Lizhou31/TfminiPlus_Tower/README.md

# TfminiPlus_Tower

## An easy use distance sensors (Tfmini-plus) Tower
* Plug and Play
* Easy to Install

## TODO
* Add watchdog to prevent I2C connection error
* Add future extendible
