Lizhou31/TfminiPlus_Tower/TPT_PCB/TPT_PCB.kicad_pcb

## KiCad design TPT_PCB/TPT_PCB.kicad_pcb (2021-08-17)

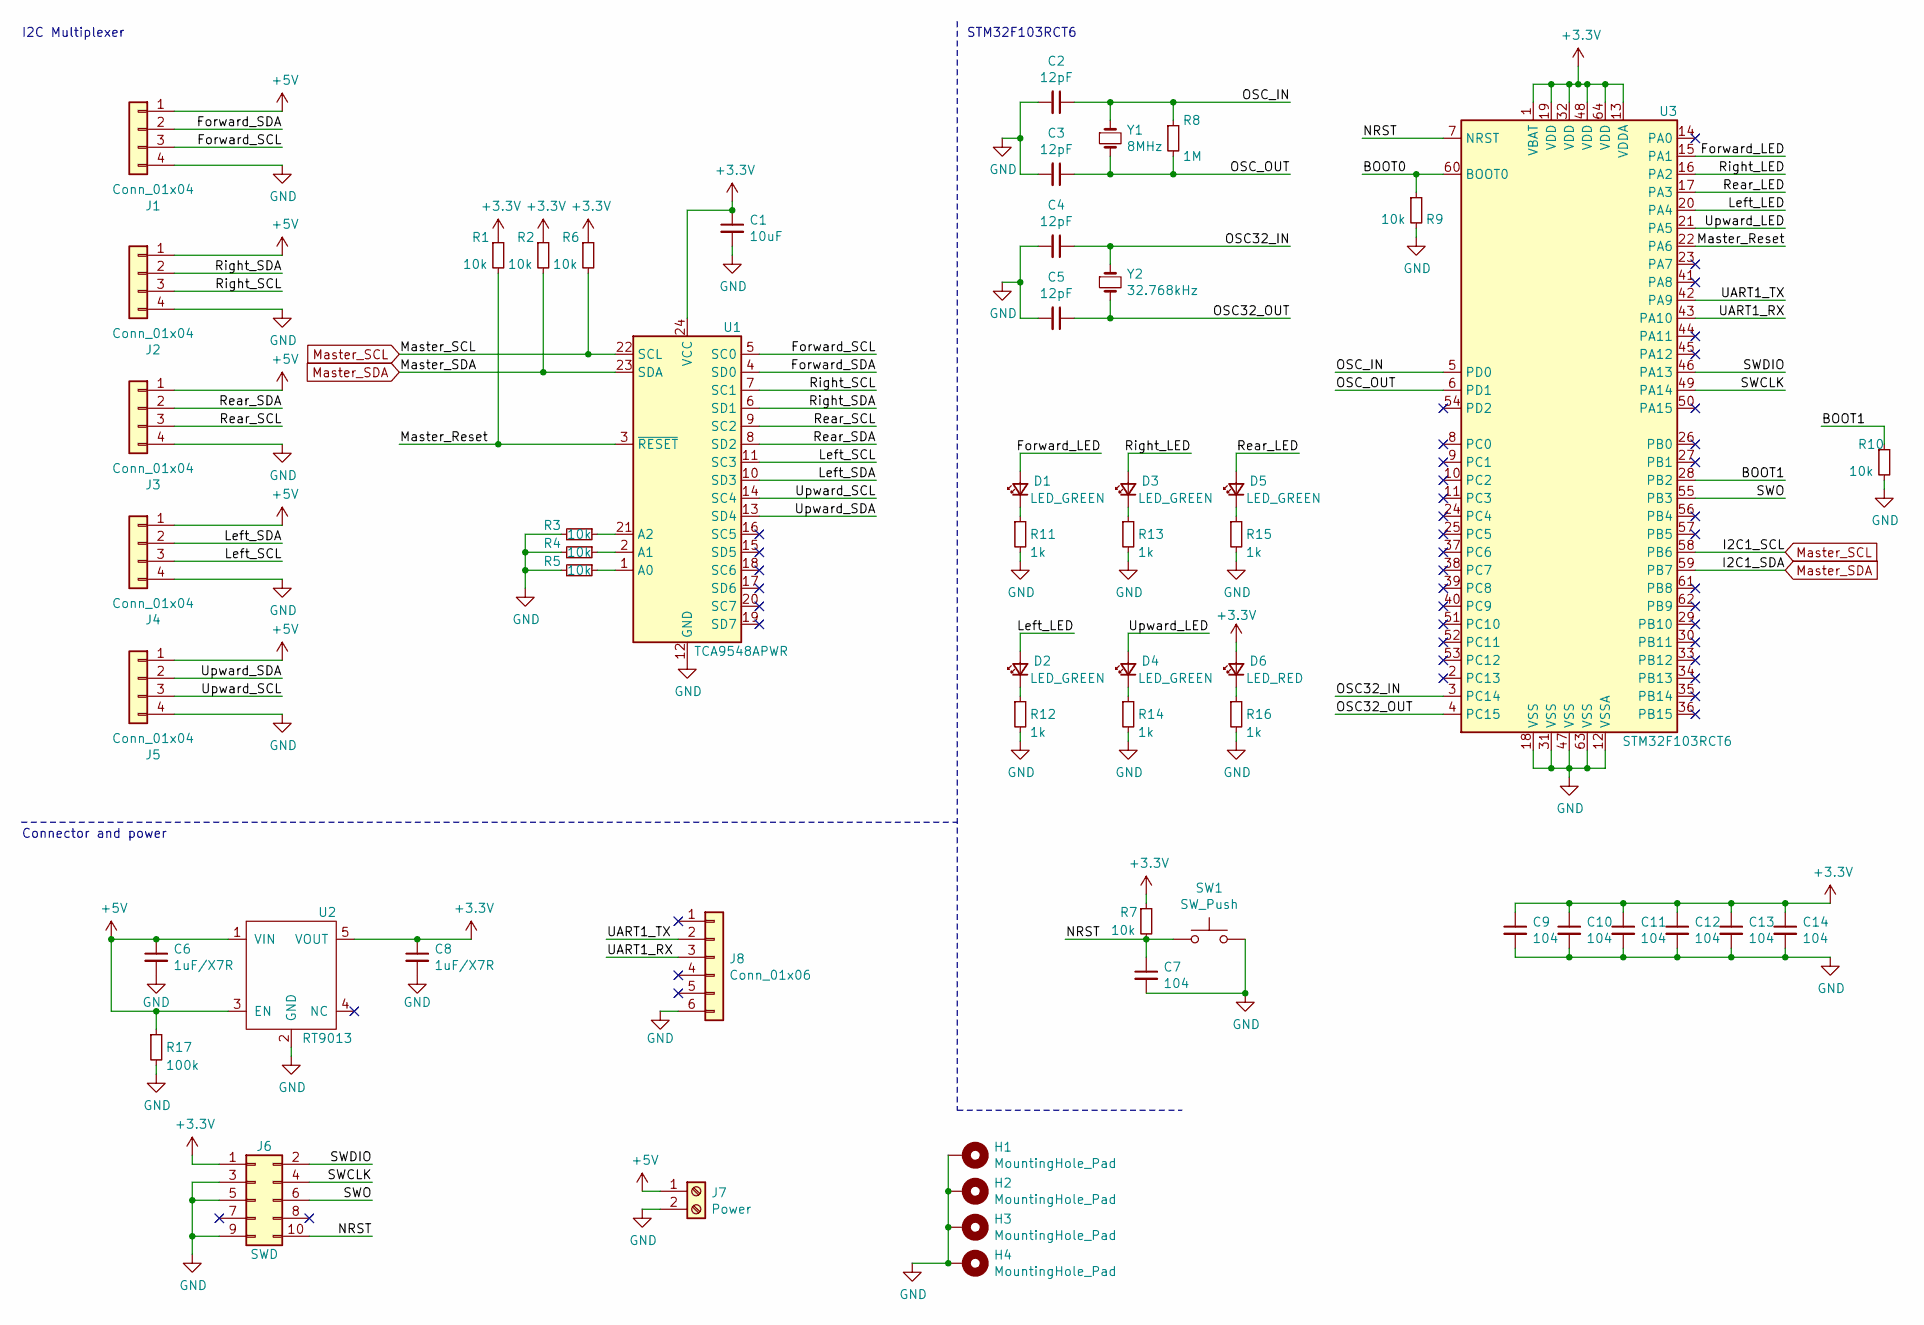
[picture p1: schematic TPT_PCB.sch, tfmini_tower]

Parts:
C1: 10uF; C_0805_2012Metric
C2, C3, C4, C5: 12pF; C_0805_2012Metric
C6, C8: 1uF/X7R; C_0805_2012Metric
C7, C9, C10, C11, C12, C13, C14: 104; C_0805_2012Metric
D1, D2, D3, D4, D5: LED_GREEN; LED_0805_2012Metric
D6: LED_RED; LED_0805_2012Metric
H1, H2, H3, H4: MountingHole_Pad; MountingHole_4.3mm_M4_Pad_Via
J1, J2, J3, J4: Conn_01x04; JST_GH_SM04B-GHS-TB_1x04-1MP_P1.25mm_Horizontal
J5: Conn_01x04; JST_GH_BM04B-GHS-TBT_1x04-1MP_P1.25mm_Vertical
J6: SWD; Samtec_HLE-105-02-xx-DV-TE_2x05_P2.54mm_Horizontal
J7: Power; TerminalBlock_Phoenix_PT-1,5-2-3.5-H_1x02_P3.50mm_Horizontal
J8: Conn_01x06; JST_GH_SM06B-GHS-TB_1x06-1MP_P1.25mm_Horizontal
R1, R2, R3, R4, R5, R6, R7, R9, R10: 10k; R_0805_2012Metric
R8: 1M; R_0805_2012Metric
R11, R12, R13, R14, R15, R16: 1k; R_0805_2012Metric
R17: 100k; R_0805_2012Metric
SW1: SW_Push; SW_Push_1P1T_NO_6x6mm_H9.5mm
U1: TCA9548APWR; TSSOP-24_4.4x7.8mm_P0.65mm
U2: RT9013; SOT94P279X129-5N
U3: STM32F103RCT6; LQFP-64_10x10mm_P0.5mm
Y1: 8MHz; XTAL_ABLS-8.000MHZ-B2-T
Y2: 32.768kHz; XTAL_AB26TRB-32.768KHZ-T

Connections:
+3V3: C1.1, C8.1, C9.1, C10.1, C11.1, C12.1, C13.1, C14.1, D6.2 (A), J6.1, R1.1, R2.1, R6.1, R7.1, U1.24 (VCC), U2.5 (VOUT), U3.1 (VBAT), U3.13 (VDDA), U3.19 (VDD), U3.32 (VDD), U3.48 (VDD), U3.64 (VDD)
+5V: C6.1, J1.1, J2.1, J3.1, J4.1, J5.1, J7.1, R17.1, U2.1 (VIN), U2.3 (EN)
/BOOT0: R9.1, U3.60 (BOOT0)
/BOOT1: R10.1, U3.28 (PB2)
/Forward_LED: D1.2 (A), U3.15 (PA1)
/Forward_SCL: J1.3, U1.5 (SC0)
/Forward_SDA: J1.2, U1.4 (SD0)
/Left_LED: D2.2 (A), U3.20 (PA4)
/Left_SCL: J4.3, U1.11 (SC3)
/Left_SDA: J4.2, U1.10 (SD3)
/Master_Reset: R1.2, U1.3 (~RESET), U3.22 (PA6)
/NRST: C7.1, J6.10, R7.2, SW1.1, U3.7 (NRST)
/OSC32_IN: C4.1, U3.3 (PC14), Y2.1
/OSC32_OUT: C5.1, U3.4 (PC15), Y2.2
/OSC_IN: C2.1, R8.1, U3.5 (PD0), Y1.1
/OSC_OUT: C3.1, R8.2, U3.6 (PD1), Y1.2
/Rear_LED: D5.2 (A), U3.17 (PA3)
/Rear_SCL: J3.3, U1.9 (SC2)
/Rear_SDA: J3.2, U1.8 (SD2)
/Right_LED: D3.2 (A), U3.16 (PA2)
/Right_SCL: J2.3, U1.7 (SC1)
/Right_SDA: J2.2, U1.6 (SD1)
/SWCLK: J6.4, U3.49 (PA14)
/SWDIO: J6.2, U3.46 (PA13)
/SWO: J6.6, U3.55 (PB3)
/UART1_RX: J8.3, U3.43 (PA10)
/UART1_TX: J8.2, U3.42 (PA9)
/Upward_LED: D4.2 (A), U3.21 (PA5)
/Upward_SCL: J5.3, U1.14 (SC4)
/Upward_SDA: J5.2, U1.13 (SD4)
GND: C1.2, C2.2, C3.2, C4.2, C5.2, C6.2, C7.2, C8.2, C9.2, C10.2, C11.2, C12.2, C13.2, C14.2, H1.1, H2.1, H3.1, H4.1, J1.4, J2.4, J3.4, J4.4, J5.4, J6.3, J6.5, J6.9, J7.2, J8.6, R3.2, R4.2, R5.2, R9.2, R10.2, R11.2, R12.2, R13.2, R14.2, R15.2, R16.2, R17.2, SW1.2, U1.12 (GND), U2.2 (GND), U3.12 (VSSA), U3.18 (VSS), U3.31 (VSS), U3.47 (VSS), U3.63 (VSS)
Master_SCL: R6.2, U1.22 (SCL), U3.58 (PB6)
Master_SDA: R2.2, U1.23 (SDA), U3.59 (PB7)
unnamed: D1.1 (K), R11.1
unnamed: D2.1 (K), R12.1
unnamed: D3.1 (K), R13.1
unnamed: D4.1 (K), R14.1
unnamed: D5.1 (K), R15.1
unnamed: D6.1 (K), R16.1
unnamed: R3.1, U1.21 (A2)
unnamed: R4.1, U1.2 (A1)
unnamed: R5.1, U1.1 (A0)

Notes on the sheet:
I2C Multiplexer
Connector and power
STM32F103RCT6

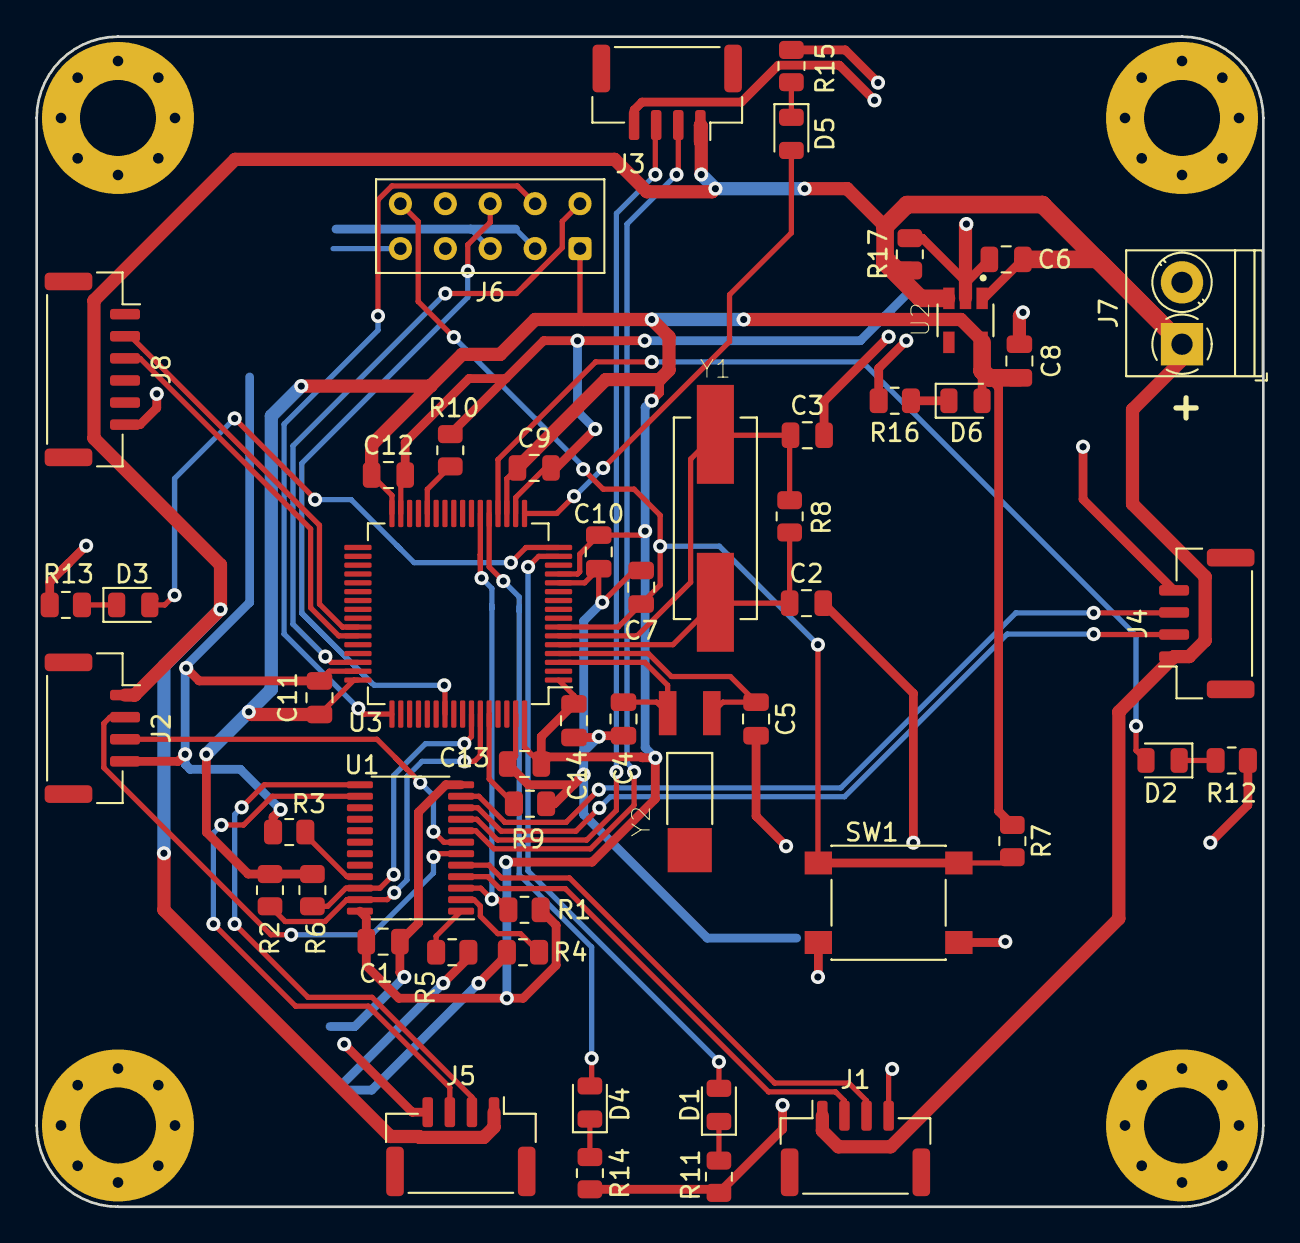
[picture p2: board TPT_PCB.kicad_pcb from above]

Board: 2 copper layers, 69.4 x 66.2 mm, 55 parts (0 on the bottom side), 42 nets.
