Lizhou31/TfminiPlus_Tower/DevSpace/Core/Src/main.c

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
/* Includes ------------------------------------------------------------------*/
#include "main.h"

/* USER CODE BEGIN Includes */
#include "tfmini_plus.h"
/* USER CODE END Includes */

/* USER CODE BEGIN PD */
// #define DEBUG
/* USER CODE END PD */

/* USER CODE BEGIN PM */
I2CHandler i2chandler;
/* USER CODE END PM */


void SystemClock_Config(void);
static void MX_GPIO_Init(void);
static void MX_I2C1_Init(void);
static void MX_USART1_UART_Init(void);
static void MX_IWDG_Init(void);
/* USER CODE BEGIN PFP */
#ifdef DEBUG
extern void initialise_monitor_handles(void);
#endif
/* USER CODE END PFP */

/**
  * @brief  The application entry point.
  * @retval int
  */
int main(void)
{
  /* USER CODE BEGIN 1 */
#ifdef DEBUG
  initialise_monitor_handles();
#endif
  /* USER CODE END 1 */

  /* MCU Configuration--------------------------------------------------------*/

  /* Reset of all peripherals, Initializes the Flash interface and the Systick. */

  LL_APB2_GRP1_EnableClock(LL_APB2_GRP1_PERIPH_AFIO);
  LL_APB1_GRP1_EnableClock(LL_APB1_GRP1_PERIPH_PWR);

  NVIC_SetPriorityGrouping(NVIC_PRIORITYGROUP_4);

  /* System interrupt init*/

  /** DISABLE: JTAG-DP Disabled and SW-DP Disabled
  */
  LL_GPIO_AF_EnableRemap_SWJ();

  /* USER CODE BEGIN Init */
  UARTHANDLER uart1handler;
  /* USER CODE END Init */

  /* Configure the system clock */
  SystemClock_Config();

  /* USER CODE BEGIN SysInit */
  LL_SYSTICK_EnableIT();
  NVIC_SetPriority(SysTick_IRQn, (1UL << __NVIC_PRIO_BITS) - 1UL); /* set Priority for Systick Interrupt */
                                                                   /* USER CODE END SysInit */

  /* Initialize all configured peripherals */
  MX_GPIO_Init();
  MX_I2C1_Init();
  MX_USART1_UART_Init();
  // MX_IWDG_Init();
  /* USER CODE BEGIN 2 */
  i2chandler_init(&i2chandler, I2C1);
  uart1handler->Instance = USART1;
  uart1handler->ErrorCode = HAL_UART_ERROR_NONE;
  __IO uint16_t mavlinklength = 0;
  tfmini_handler tfmini[] =
      {{.DevAddress = 0x10,
        .channel = 0b00000001,
        .ErrorCode = TFMINI_ERROR_NONE},
       {.DevAddress = 0x13,
        .channel = 0b00000010,
        .ErrorCode = TFMINI_ERROR_NONE},
       {.DevAddress = 0x12,
        .channel = 0b00000100,
        .ErrorCode = TFMINI_ERROR_NONE},
       {.DevAddress = 0x11,
        .channel = 0b00001000,
        .ErrorCode = TFMINI_ERROR_NONE},
       {.DevAddress = 0x14,
        .channel = 0b00010000,
        .ErrorCode = TFMINI_ERROR_NONE}};
  mavlink_message_t msg;
  uint8_t Txmsg[174] = {0};

  LL_GPIO_SetOutputPin(GPIOA, LL_GPIO_PIN_6);
  Delay(100U);
  ScanDistanceSensor(tfmini);
  if (tfmini_channel_count & (0b00000001 << 0))
    LL_GPIO_SetOutputPin(GPIOA, LL_GPIO_PIN_1);
  if (tfmini_channel_count & (0b00000001 << 1))
    LL_GPIO_SetOutputPin(GPIOA, LL_GPIO_PIN_2);
  if (tfmini_channel_count & (0b00000001 << 2))
    LL_GPIO_SetOutputPin(GPIOA, LL_GPIO_PIN_3);
  if (tfmini_channel_count & (0b00000001 << 3))
    LL_GPIO_SetOutputPin(GPIOA, LL_GPIO_PIN_4);
  if (tfmini_channel_count & (0b00000001 << 4))
    LL_GPIO_SetOutputPin(GPIOA, LL_GPIO_PIN_5);
  uint16_t distance[72] = {0};
  /* USER CODE END 2 */

  /* Infinite loop */
  /* USER CODE BEGIN WHILE */
  while (1)
  {
    /* USER CODE END WHILE */

    /* USER CODE BEGIN 3 */
    Delay(50U);
    for (uint8_t i = 0; i < 5; i++)
    {
      if (tfmini_channel_count & (0b00000001 << i))
      {
        updateDistance(tfmini + i);
        if((tfmini + i)->Distance > 20 && (tfmini + i)->Distance != 0)
          distance[i] = (tfmini + i)->Distance;
        else if((tfmini + i)->Distance == 0)
          distance[i] = 1201;
      }
      else
      {
        distance[i] = 1201;
      }
    }
    mavlink_msg_obstacle_distance_pack(1, 191, &msg, ((uint64_t)GetTick()) * 1000, 2, distance, 0, 20, 1200, 90.f, 0.f, 0);
    mavlinklength = mavlink_msg_to_send_buffer(Txmsg, &msg);
    UART_Transmit(uart1handler, Txmsg, mavlinklength, 0x20);
    mavlink_msg_distance_sensor_pack(1, 191, &msg, ((uint64_t)GetTick()) * 1000, 20, 1200, distance[4], 2, 5, 24, 255, 0, 0, 0, 100);
    mavlinklength = mavlink_msg_to_send_buffer(Txmsg, &msg);
    UART_Transmit(uart1handler, Txmsg, mavlinklength, 0x20);
    
  }
  /* USER CODE END 3 */
}

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
