Lizhou31/TfminiPlus_Tower/(commit log)

2021-03-19 tfmini_plus use i2c
2021-03-20 add uart transmit support
2021-03-22 add mavlink_v2 lib and use uart transmit
2021-03-24 fix over malloc cause hardfault
    [main.c]
2021-04-12 change tfmini read cmd with i2c multiplexer
2021-04-12 add sensor scan
2021-04-14 fix wrong systemtick, add reset pin and led toggle
    [PV_SystemTick.c, PV_SystemTick.h, main.c, tfmini_plus.c]
2021-04-14 fix some strange error, add minmum distance limit
    [PV_SystemTick.c, PV_SystemTick.h, main.c]
2021-04-16 add iwdg,but havn't used. TODO:fix unbounded range
    [main.c, tfmini_plus.c]
2021-04-17 修改當空曠區域時的0值問題
2021-04-19 a layout nood add PCB layout file
    [TPT_PCB.kicad_pcb, TPT_PCB.sch]
2021-04-19 change i2c standard mode to fast mode
2021-04-26 update pcb layout, but there are some problem. Must be re-do.
    [TPT_PCB.sch]
2021-04-28 re-layout and generate gbr file
    [TPT_PCB-B_Cu.gbr, TPT_PCB-B_Mask.gbr, TPT_PCB-B_Paste.gbr, TPT_PCB-B_SilkS.gbr, TPT_PCB-Edge_Cuts.gbr, TPT_PCB-F_Cu.gbr, TPT_PCB-F_Mask.gbr, TPT_PCB-F_Paste.gbr]
2021-04-28 add boom
    [TPT_PCB.csv, TPT_PCB.kicad_pcb]
2021-06-17 修改PCB錯誤標示
    [TPT_PCB.kicad_pcb, TPT_PCB2.csv]
2021-07-03 修正PCB文字層錯誤
    [TPT_PCB.kicad_pcb]
2021-07-03 fix wrong component id
    [main.c]
2021-07-06 change SWD connector add layout TODO list
    [TPT_PCB.kicad_pcb, TPT_PCB.sch]
2021-08-17 some pcb change
    [TPT_PCB.kicad_pcb]
2021-08-17 optimize i2c and tfmini-plus lib
